Jaiyeolacole/Wireless-pressure-sensor/pics/IMG_20261023_102219_094.jpg

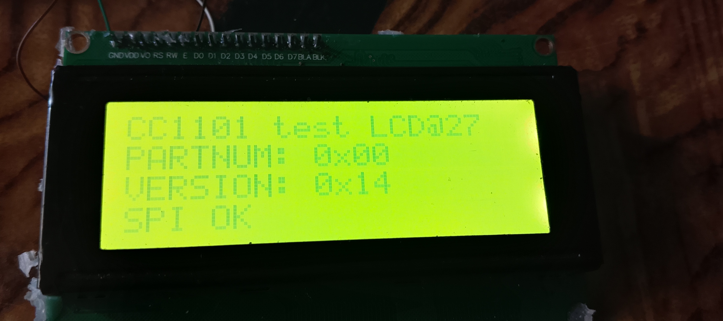
pics/IMG_20261023_102219_094.jpg
