Jaiyeolacole/Wireless-pressure-sensor/pics/IMG_20261023_102228_452.jpg

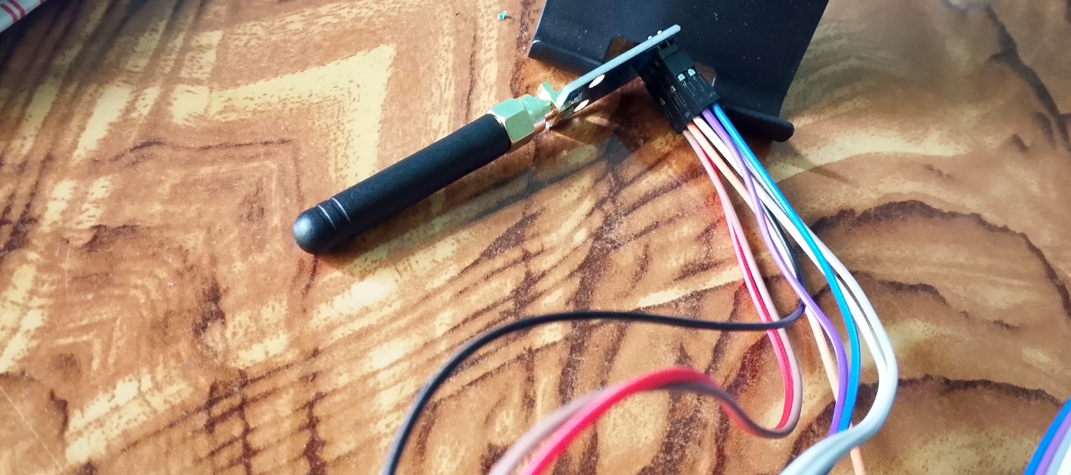
pics/IMG_20261023_102228_452.jpg
