Jaiyeolacole/Wireless-pressure-sensor/pics/IMG_20261025_075716_495.jpg

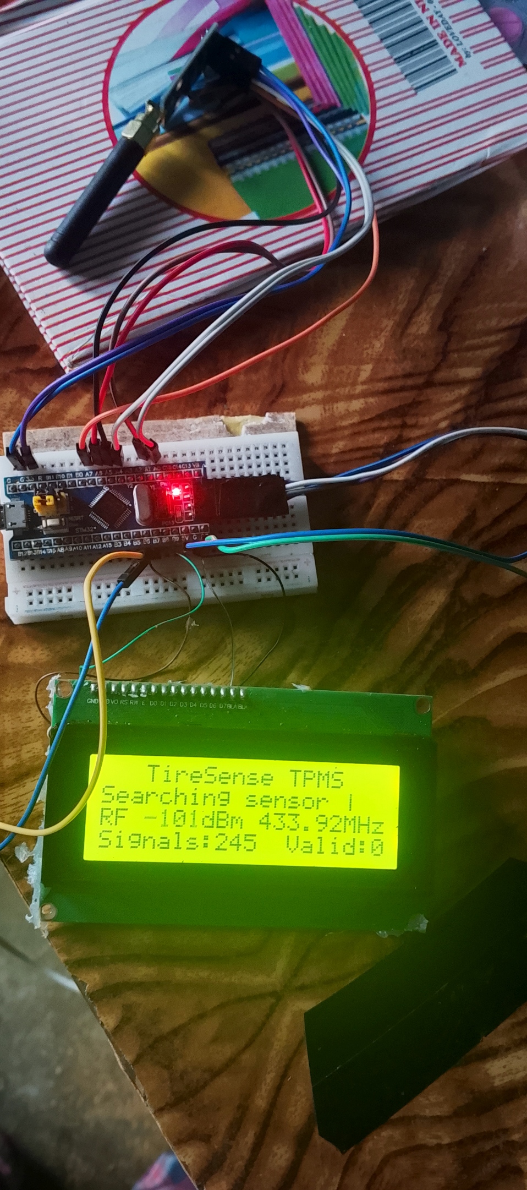
pics/IMG_20261025_075716_495.jpg
