Jaiyeolacole/Wireless-pressure-sensor/Core/Src/main.c

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
/* Includes ------------------------------------------------------------------*/
#include "main.h"
#include "usb_device.h"

/* USER CODE BEGIN Includes */
#include "cc1101.h"
#include "lcd_i2c.h"
#include "app.h"
#include <stdio.h>
/* USER CODE END Includes */

I2C_HandleTypeDef hi2c1;

SPI_HandleTypeDef hspi1;

TIM_HandleTypeDef htim2;
TIM_HandleTypeDef htim3;

void SystemClock_Config(void);
static void MX_GPIO_Init(void);
static void MX_I2C1_Init(void);
static void MX_SPI1_Init(void);
static void MX_TIM2_Init(void);
static void MX_TIM3_Init(void);
/**
  * @brief  The application entry point.
  * @retval int
  */
int main(void)
{

  /* MCU Configuration--------------------------------------------------------*/

  /* Reset of all peripherals, Initializes the Flash interface and the Systick. */
  HAL_Init();

  /* Configure the system clock */
  SystemClock_Config();

  /* USER CODE BEGIN SysInit */
  /*
   * Blue Pill USB re-enumeration trick: hold D+ (PA12) low for 10 ms so the PC
   * sees a "disconnect" after every reset/flash and enumerates the COM port again.
   */
  {
    GPIO_InitTypeDef g = {0};
    __HAL_RCC_GPIOA_CLK_ENABLE();
    g.Pin = GPIO_PIN_12;
    g.Mode = GPIO_MODE_OUTPUT_PP;
    g.Speed = GPIO_SPEED_FREQ_LOW;
    HAL_GPIO_Init(GPIOA, &g);
    HAL_GPIO_WritePin(GPIOA, GPIO_PIN_12, GPIO_PIN_RESET);
    HAL_Delay(10);
    HAL_GPIO_DeInit(GPIOA, GPIO_PIN_12);   /* release: the USB peripheral takes the pin */
  }
  /* USER CODE END SysInit */

  /* Initialize all configured peripherals */
  MX_GPIO_Init();
  MX_I2C1_Init();
  MX_SPI1_Init();
  MX_TIM2_Init();
  MX_TIM3_Init();
  MX_USB_DEVICE_Init();
  /* USER CODE BEGIN 2 */
  char line[21];   /* 20 chars + terminator */

  if (lcd_init(&hi2c1) != HAL_OK) {
      /* No LCD found at 0x27 or 0x3F: fast-blink the onboard LED (PC13) forever */
      while (1) {
          HAL_GPIO_TogglePin(GPIOC, GPIO_PIN_13);
          HAL_Delay(100);
      }
  }

  /* ---- Step 1 check (kept as a power-on self test) ---- */
  lcd_print_at(0, 0, "   TireSense TPMS");

  if (cc1101_init(&hspi1) != CC1101_OK) {
      lcd_print_at(0, 1, "Radio: NOT FOUND");
      lcd_print_at(0, 2, "Check 3V3,CS,MISO");
  } else {
      uint8_t part = 0xFF, ver = 0xFF;
      cc1101_read_status_reg(CC1101_PARTNUM, &part);
      cc1101_read_status_reg(CC1101_VERSION, &ver);

      snprintf(line, sizeof line, "Radio CC1101 v%02X", ver);
      lcd_print_at(0, 1, line);
      snprintf(line, sizeof line, "Self-test: %s", (part == 0x00 && (ver == 0x14 || ver == 0x04)) ? "OK" : "FAIL");
      lcd_print_at(0, 2, line);
      lcd_print_at(0, 3, "433.92 MHz receiver");
  }
  HAL_Delay(1500);   /* leave the self-test on screen briefly */

  /* ---- Step 2: radio in raw receive mode + burst capture ---- */
  app_init(&htim2, &htim3);
  /* USER CODE END 2 */

  /* Infinite loop */
  /* USER CODE BEGIN WHILE */
  while (1)
  {
    /* USER CODE END WHILE */

    /* USER CODE BEGIN 3 */
    app_loop();     /* never blocks: radio data is captured by interrupts */
  }
  /* USER CODE END 3 */
}

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
