Jaiyeolacole/Wireless-pressure-sensor/Core/Inc/main.h

#define GPIO_Output_Pin GPIO_PIN_13
#define GPIO_Output_GPIO_Port GPIOC
#define CC1101_GDO0_Pin GPIO_PIN_0
#define CC1101_GDO0_GPIO_Port GPIOA
#define CC1101_GDO2_Pin GPIO_PIN_1
#define CC1101_GDO2_GPIO_Port GPIOA
#define CC1101_CS_Pin GPIO_PIN_4
#define CC1101_CS_GPIO_Port GPIOA
#define SCL_Pin GPIO_PIN_6
#define SCL_GPIO_Port GPIOB
#define SDA_Pin GPIO_PIN_7
#define SDA_GPIO_Port GPIOB
